KatsuhiroMorishita/electronic_music_box/PIC/readme.txt

PICで作る電子オルゴールの資料です。
以下のサイトでも解説しています。
http://morimori2008.web.fc2.com/contents/PIC/electronic_music_box/index.html
