KatsuhiroMorishita/electronic_music_box/Arduino/解説スライド_201611.pptx

## ArduinoとExcelで作る 電子オルゴール

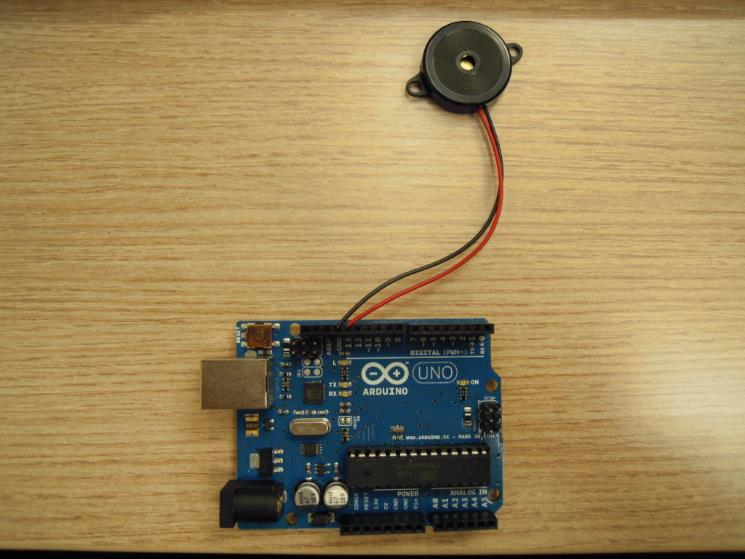
[picture p3: figure]

熊本高等専門学校
2015-08-13 update
森下功啓

## 電子オルゴールに必要なもの

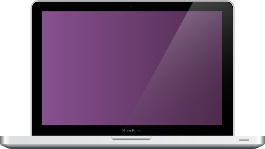
[picture p4: figure]
MoonBook Laptop by dchest
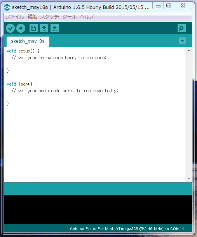
[picture p5: figure]

Arduino IDE
（上の図はWindows用）

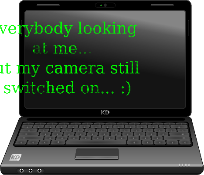
[picture p6: figure]
PC, laptop, notebook, waching by Keistutis
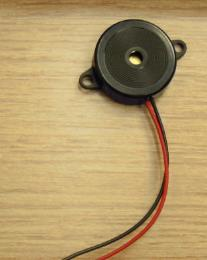
[picture p7: figure]

圧電スピーカー

MacやPC(パソコン)

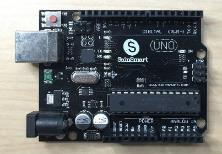
[picture p8: figure]

Arduino
（アルデュイーノ）

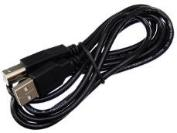
[picture p9: figure]
ＵＳＢケーブル Ａオス－Ｂオス １．５ｍ Ａ－Ｂ

通信ケーブル

http://akizukidenshi.com/catalog/g/gC-07605/

## 音を出す原理

- 音は、空気の振動です
- 圧電スピーカーは電圧をかけると変形する素子です
- ↑は250 Hzで電圧を変化させると250 Hzの音が出ます
  - ヘルツHzは、1秒間に繰り返される現象の回数
- Aｒduinoには、そのための機能が備わっています

電圧を変化させる

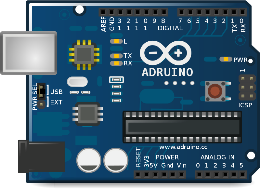
[picture p10: figure]
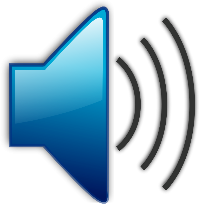
[picture p11: figure]

## 電子オルゴールで利用する主な関数

- tone(ポート番号, 周波数)
  - 特定の周波数の矩形信号を出力する
- delay(待ち時間[ms])
  - 引数で指定した時間だけ待つ

## Slide 5

オルゴールの作り方

## 圧電スピーカを接続する

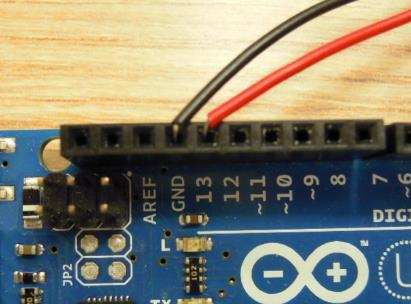
[picture p12: figure]

差し込む

## ArduinoとPCをUSBで接続する

- 電源をArduinoに供給しつつ、プログラムを書き込んだり、Arduinoとシリアル通信するためにUSBケーブルで接続します

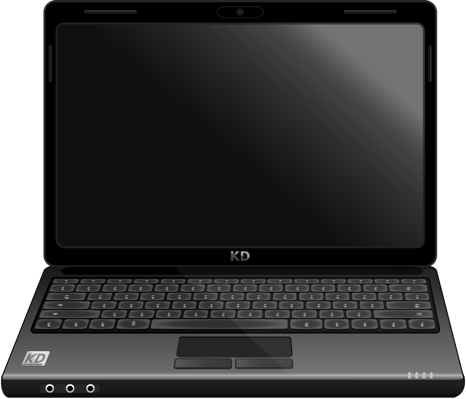
[picture p13: figure]
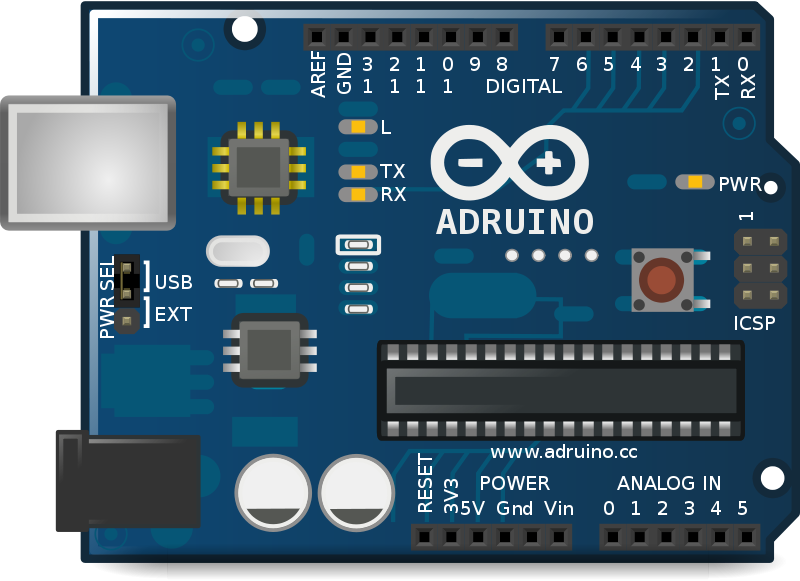
[picture p14: figure]

USBケーブル

## スケッチ作成補助ツールを入手

下記リンクよりダウンロードできます

https:// (https://github.com/KatsuhiroMorishita/electronic_music_box/blob/master/Arduino/Arduino%E3%82%AA%E3%83%AB%E3%82%B4%E3%83%BC%E3%83%AB%E7%94%A8Excel%E3%83%95%E3%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)github.com/KatsuhiroMorishita/electronic_music_box/blob/master/Arduino/Arduino%E3%82%AA%E3%83%AB%E3%82%B4%E3%83%BC%E3%83%AB%E7%94%A8Excel%E3%83%95%E3%82%A1%E3%82%A4%E3%83%AB.xlsx

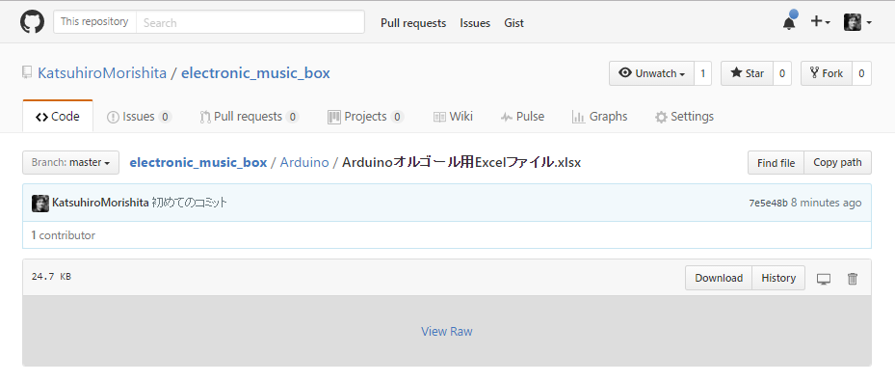
[picture p15: figure]

クリック

## スケッチ作成補助ツールを起動

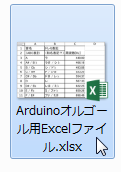
[picture p16: figure]

アイコンをダブルクリックします

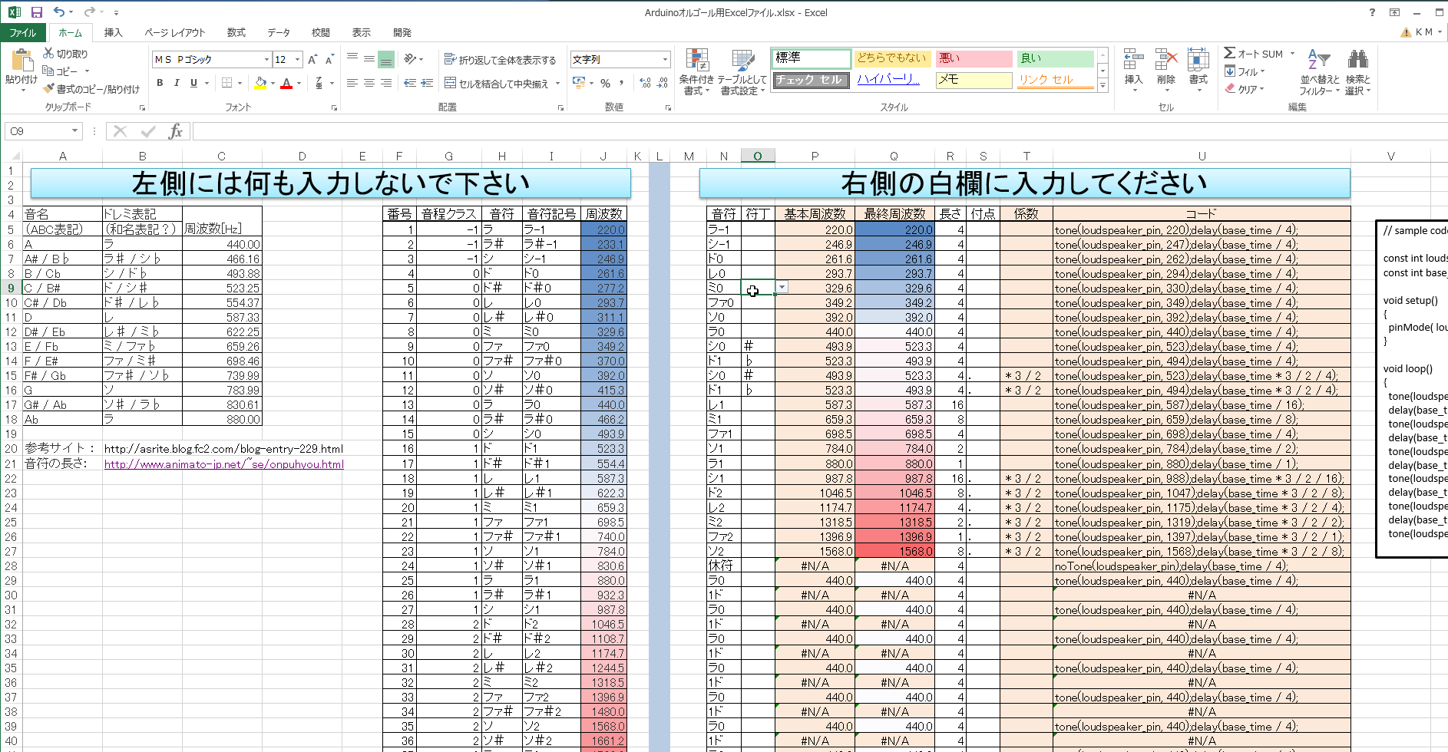
[picture p17: figure]

起動

## スケッチ作成補助ツールの説明

入力欄はN, O, R, Sの4列

## N列

- ドレミファなどの音階を入力

## O列

- #や♭を入力

## R列

- 音の長さを入力
  - 4分音符なら”4”

## S列

- 付点（音の長さが1.5倍）を入力

## 入力方法

1. セルを選択
2. 右側に出る▼をクリック
3. 選択肢が表示される
4. 選択肢をクリック

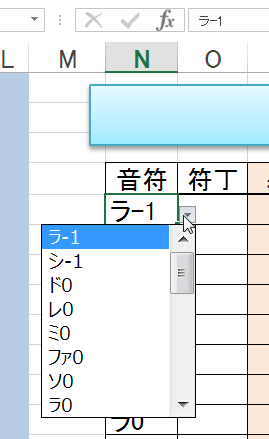
[picture p18: figure]

マウス

## 自動生成されるスケッチ

- U列に出力される
- Excelが演奏部分だけ自動生成する

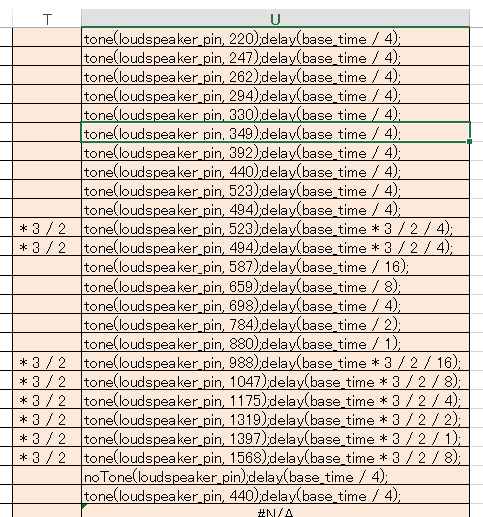
[picture p19: figure]

## ツールを使う流れ

1. 楽譜を読む（音階と長さ）
2. Excelに音符を入力
3. 生成されたコードをテキストエディタにコピペ
  1. TeraPadを推奨
  2. ダブルコーテーション「”」を置換機能で削除
  3. 再びコピー
4. Arduino IDEにペースト
  1. loop()関数内に貼り付ける

## 生成されたコードをテキストエディタにコピペ

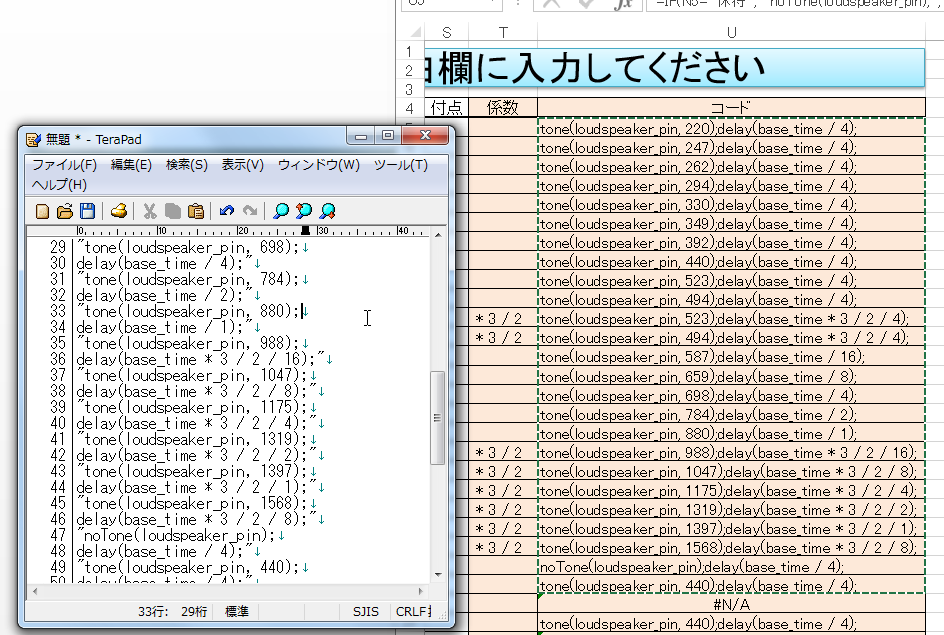
[picture p20: figure]

コピー

ペースト
（貼り付け）

## 「“」を置換する（置換機能の起動）

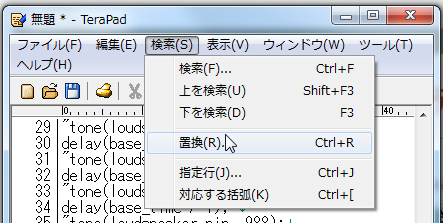
[picture p21: figure]

## 置換条件の設定

半角で「”」を入力

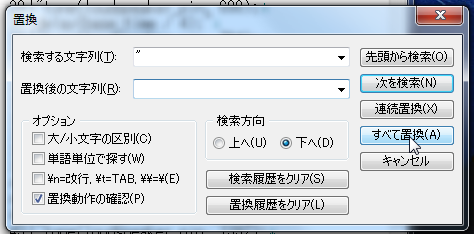
[picture p22: figure]

空欄

クリック

## 置換の実行

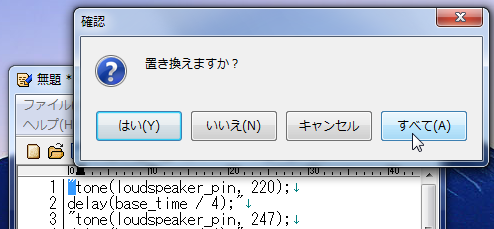
[picture p23: figure]

クリック

## 「“」が取れた(^o^)/

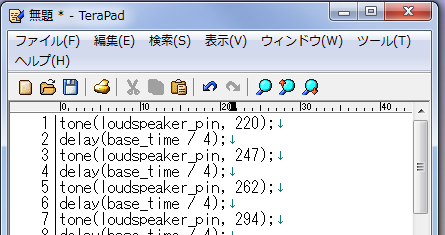
[picture p24: figure]

## IDE起動！ー＞プログラムを書く

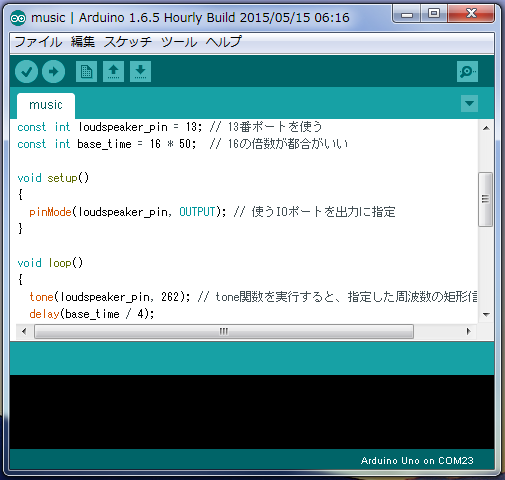
[picture p25: figure]

置換済みのコードをloop()に貼り付け

＊Windows版のスクリーンショットです

サンプル入手先
https:// (https://github.com/KatsuhiroMorishita/electronic_music_box/tree/master/Arduino/code/music)github.com/KatsuhiroMorishita/electronic_music_box/tree/master/Arduino/code/music

## スケッチ例

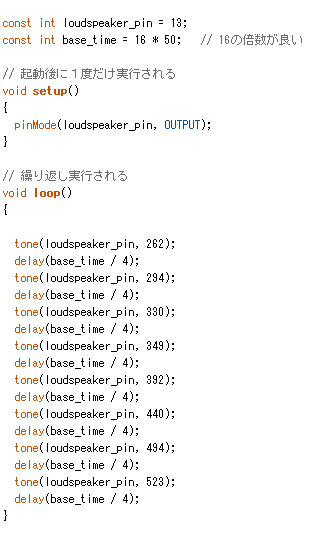
[picture p26: figure]

## 設定して

- ボードのシリーズを選ぶ
- ポートのマイコンor電圧を選ぶ

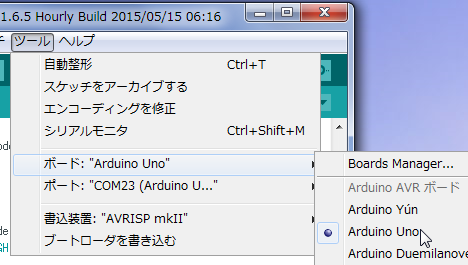
[picture p27: figure]

＊Windows版のスクリーンショットです

## 書き込んで

- コンパイル＆書き込み（エラーが出たら修正）

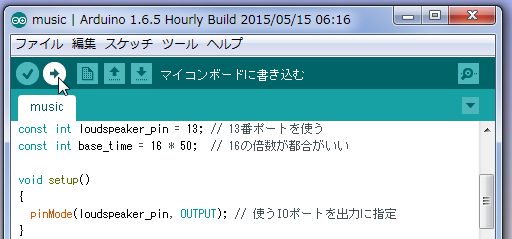
[picture p28: figure]

＊Windows版のスクリーンショットです

クリック

## 完成！！

- 動作の例
  - https:// (https://www.youtube.com/watch?v=UCOcOTAO26Q)www.youtube.com/watch?v=UCOcOTAO26Q

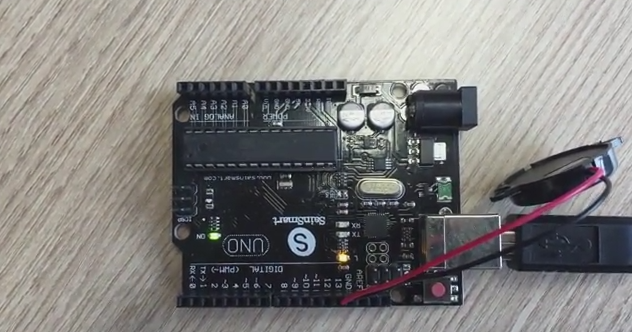
[picture p29: figure]

## 自分のオリジナル曲を 作ってみよう

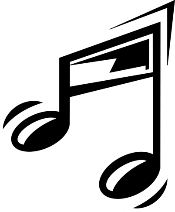
[picture p30: figure]

*複数台を連携させれば複雑な音楽が実現するかも！？

## 参考資料

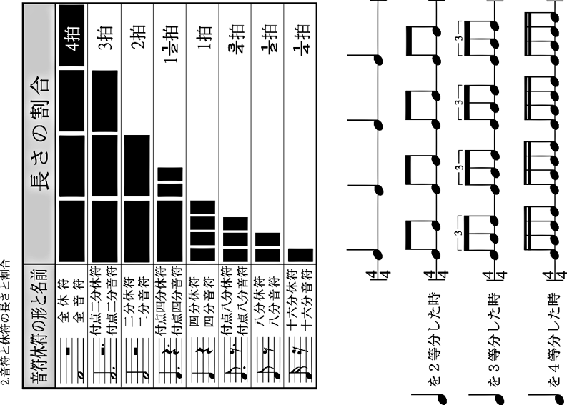
[picture p31: figure]

http://www.animato-jp.net/~se/onpuhyou. (http://www.animato-jp.net/~se/onpuhyou.html)html (http://www.animato-jp.net/~se/onpuhyou.html)
