KatsuhiroMorishita/electronic_music_box/PIC/circuit/readme.txt

CADは水魚堂さん作のBSch3を利用しています。
http://www.suigyodo.com/online/oldedit.htm
