KatsuhiroMorishita/electronic_music_box/PIC/circuit/回路図.BMP

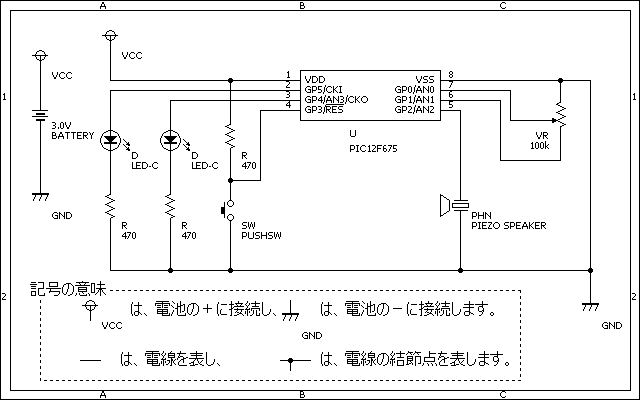
PIC/circuit/回路図.BMP
