KatsuhiroMorishita/electronic_music_box/PIC/photo/2008年オープンキャンパス版/DSCN1486.JPG

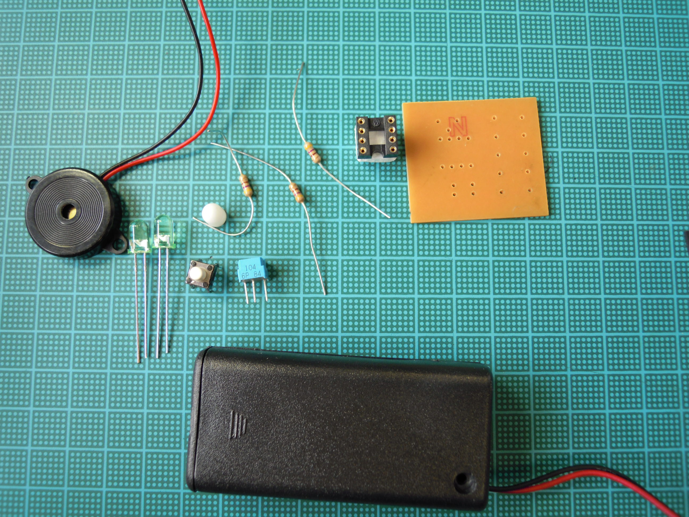
PIC/photo/2008年オープンキャンパス版/DSCN1486.JPG
