KatsuhiroMorishita/electronic_music_box/PIC/photo/2008年オープンキャンパス版/DSCN1491.JPG

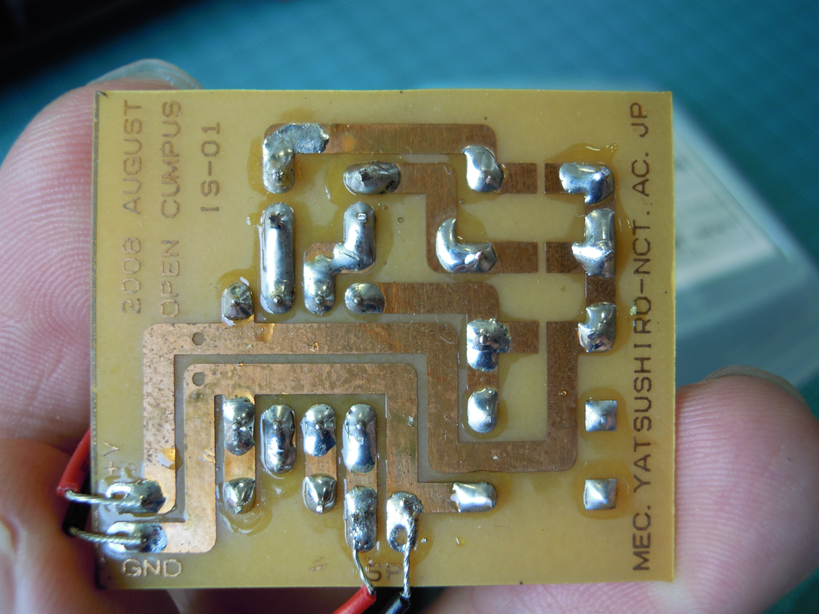
PIC/photo/2008年オープンキャンパス版/DSCN1491.JPG
