KatsuhiroMorishita/electronic_music_box/(list of files, drawings)

Other design files:
PIC/circuit/オルゴール2007a.pcb
