KatsuhiroMorishita/electronic_music_box/(commit log)

2016-11-01 初めてのコミット
    [Arduinoオルゴール用Excelファイル.xlsx, MusicBoxforWEBver_201402.xls, オルゴール2007a.pcb]
2016-11-01 解説スライド内のリンクを更新
